mmalecki/lp-1/(commit log)

2023-01-18 Add initial implementation
    [leg-mount-pin.scad, leg-mount.scad, leg-pad.scad, leg-rail-mount.scad, legs.scad, parameters.scad, rail-joiner.scad]
2023-02-13 Add a comment on leg mount position
    [legs.scad]
2023-03-09 pad -> foot
    [leg-foot.scad]
2023-03-09 Refactor for the part and variable names to make more sense
    [leg-hinge-mount.scad, leg-hinge.scad, leg-mount-pin.scad, leg-mount.scad, leg-rail-mount.scad, legs.scad, parameters.scad, stand-center.scad]
2023-06-19 Implement layer adhesion rotation
    [leg-hinge-mount.scad, parameters.scad]
2023-06-19 Add a launch pad assembly
    [launch-pad.scad]
2023-06-20 Add a fuller leg assembly
    [launch-pad.scad, leg-foot.scad, legs.scad, parameters.scad, stand-center.scad]
